SkillsHUB-Electronics/car-alarm/firmware/car_alarm/Alerts.cpp

#include "Alerts.h"
#include "config.h"
#include "Settings.h"

void Alerts::begin() {
#if INC_BUZZER
  pinMode(PIN_BUZZER, OUTPUT);
#endif
#if INC_LED
  pinMode(PIN_LED_RED, OUTPUT);
  pinMode(PIN_LED_YELLOW, OUTPUT);
  pinMode(PIN_LED_GREEN, OUTPUT);
#endif
  set(false, false, false, false);
}

// LEDs and buzzer are written through these so a build without them (INC_LED / INC_BUZZER = 0) does nothing.
static void writeLeds(bool red, bool yellow, bool green) {
#if INC_LED
  digitalWrite(PIN_LED_RED, red);
  digitalWrite(PIN_LED_YELLOW, yellow);
  digitalWrite(PIN_LED_GREEN, green);
#else
  (void)red; (void)yellow; (void)green;
#endif
}

static void writeBuzzer(bool on) {
#if INC_BUZZER
  digitalWrite(PIN_BUZZER, on);
#else
  (void)on;
#endif
}

void Alerts::set(bool red, bool yellow, bool green, bool buzzer) {
  writeLeds(red, yellow, green);
  writeBuzzer(buzzer && settings.buzzer);
}

// Test-IO mode: drive the outputs directly (the buzzer ignores the Settings mute).
void Alerts::test(bool red, bool yellow, bool green, bool buzzer) {
  writeLeds(red, yellow, green);
  writeBuzzer(buzzer);
}

void Alerts::update(Status status, unsigned long now, unsigned long since) {
  switch (status) {
    case Status::NORMAL:
      set(false, false, true, false);
      break;
    case Status::WARN:
      set(false, (now / 250) % 2 == 0, false, (now % 1000) < 100);
      break;
    case Status::DANGER:
      set((now / 100) % 2 == 0, false, false, (now % 200) < 100);
      break;
    case Status::SHOCK:
    case Status::BRAKE:
      set(true, false, false, (now - since) < MOTION_BUZZ_MS);
      break;
  }
}
