SkillsHUB-Electronics/car-alarm/(commit log)

2026-10-13 Initial public release: Car Distance & Shock Alarm
    Arduino UNO firmware 2.1, Android BLE app, web console, tests and docs.
2026-10-13 Add INA219/CHRG power module, ESP32 build fixes, BLE + PWA console
    - Power module (INA219 raw registers + CHRG pin), PWR,GET command, config_user.h, test_08
    - ESP32 core 3.x compile fixes (pgmspace, <new>, isfinite, Wire timeout, LINE_MAX)
    - Console: Web Bluetooth (FFE0/FFE1) transport, manifest, service worker, icons
    - Includes the uncommitted v2.1 firmware changes (HW/I2C commands) the power code depends on
    [Classifier.cpp, Commands.cpp, Commands.h, Display.h, Power.cpp, Power.h, Settings.cpp]
2026-10-13 Add ESP32 DevKit pin map
    Pins avoid strapping and input-only GPIOs; CHRG moves to GPIO13 on ESP32.
    Compile-checked only (ESP32 core 3.3.12); UNO pins and sizes unchanged.
    [config.h, config_user.h]
2026-10-13 INA219 calibration in the Calibration tab, move Compile & Upload to Settings, Android icon
    - Firmware: PCAL,GET/SET/RESET with per-mille voltage/current gains and a current offset (own EEPROM block)
    - Console: INA219 calibration card (calibrate V, calibrate I, zero offset, reset) in Calibration
    - Console: Compile & Upload card moves from Dashboard to Settings
    - Console: logo, favicon and PWA icons use the Android launcher icon
    [Commands.cpp, Commands.h, Power.cpp, Settings.cpp, Settings.h]
2026-10-15 Cloud build: compile via GitHub Actions from the hosted console, flash in the browser (#5)
    * Add cloud build: compile via GitHub Actions from the hosted console and flash in the browser
    Claude-Session: https://claude.ai/code/session_01XJr5vdSQcDNBzdZgUj2Er6
    * build-firmware: check both boards on PRs that edit the workflow
    Claude-Session: https://claude.ai/code/session_01XJr5vdSQcDNBzdZgUj2Er6
    * Firmware: use UART2 for the BLE module on ESP32 so the sketch compiles there
    Claude-Session: https://claude.ai/code/session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
2026-10-15 Console: refine layout and UX (#7)
    * Console: refine layout and UX (settings columns, mobile connect button, offline notice, contrast, focus)
    Claude-Session: https://claude.ai/code/session_01B2j21hs4MwxXFmQPys38gc
    * Console: serve logo/PWA files locally, split connect button, wider dashboard with equal-height cards, fixed event history with auto-scroll
    Claude-Session: https://claude.ai/code/session_01B2j21hs4MwxXFmQPys38gc
    ---------
2026-10-15 Console: refine Learning, Calibration and Config pages; build-time pins and interface switches (#9)
    * Console: refine Learning page layout (aligned cards)
    * Console: refine Calibration page layout (equal cards, scrollable points, accelerometer/INA side by side)
    * Console: Config page (renamed from Settings) with Device, Interfaces & pins, Runtime, Alarm and Build & upload cards
    Pin/include choices are stored in the browser only; build wiring follows.
    * Firmware + console: build-time pin overrides, I2C addresses an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
